davidlim4318/Baseball-Machine/README.md

# Baseball-Machine
MAE 156 Capstone Project Code Files
