davidlim4318/Baseball-Machine/KiCad/oc_v1/oc_v1.kicad_pcb

## KiCad design KiCad/oc_v1/oc_v1.kicad_pcb (2024-03-15)

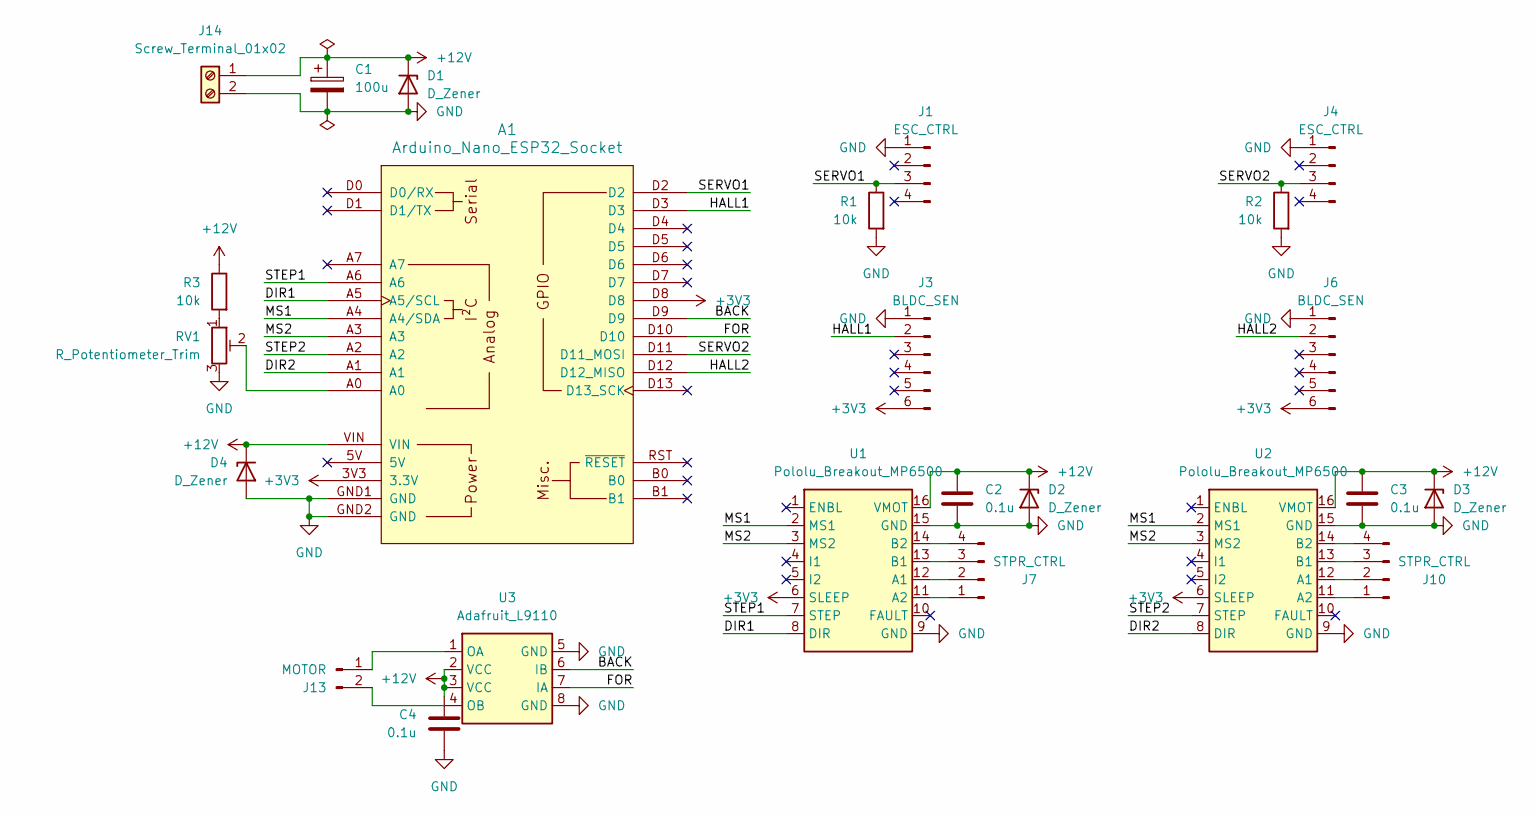
[picture p1: schematic oc_v1.kicad_sch, Onboard Controller V1]

Parts:
A1: Arduino_Nano_ESP32_Socket
C1: 100u; CP_Radial_D5.0mm_P2.50mm
C2, C3, C4: 0.1u; C_0603_1608Metric_Pad1.08x0.95mm_HandSolder
D1, D2, D3, D4: D_Zener; D_TUMD2
J1, J4: ESC_CTRL; JST_XH_S4B-XH-A_1x04_P2.50mm_Horizontal
J3, J6: BLDC_SEN; JST_XH_S6B-XH-A_1x06_P2.50mm_Horizontal
J7, J10: STPR_CTRL; JST_XH_S4B-XH-A_1x04_P2.50mm_Horizontal
J13: MOTOR; JST_XH_S2B-XH-A_1x02_P2.50mm_Horizontal
J14: Screw_Terminal_01x02; On_Shore_Tech_Barrier_Strip_2Pos
R1, R2, R3: 10k; R_0805_2012Metric_Pad1.20x1.40mm_HandSolder
RV1: R_Potentiometer_Trim; Bourns_TC33X_Potentiometer
U1, U2: Pololu_Breakout_MP6500
U3: Adafruit_L9110; DIP-8_W7.62mm_Socket_LongPads

Connections:
+3V3: A1.3V3 (3.3V), A1.D8, J3.6, J6.6, U1.6 (SLEEP), U2.6 (SLEEP)
+12V: A1.VIN, C1.1, C2.1, C3.1, C4.1, D1.1 (K), D2.1 (K), D3.1 (K), D4.1 (K), J14.1, R3.1, U1.16 (VMOT), U2.16 (VMOT), U3.2 (VCC), U3.3 (VCC)
/BACK: A1.D9, U3.6 (IB)
/DIR1: A1.A5 (A5/SCL), U1.8 (DIR)
/DIR2: A1.A1, U2.8 (DIR)
/FOR: A1.D10, U3.7 (IA)
/HALL1: A1.D3, J3.2
/HALL2: A1.D12 (D12_MISO), J6.2
/MS1: A1.A4 (A4/SDA), U1.2 (MS1), U2.2 (MS1)
/MS2: A1.A3, U1.3 (MS2), U2.3 (MS2)
/SERVO1: A1.D2, J1.3, R1.1
/SERVO2: A1.D11 (D11_MOSI), J4.3, R2.1
/STEP1: A1.A6, U1.7 (STEP)
/STEP2: A1.A2, U2.7 (STEP)
GND: A1.GND1 (GND), A1.GND2 (GND), C1.2, C2.2, C3.2, C4.2, D1.2 (A), D2.2 (A), D3.2 (A), D4.2 (A), J1.1, J3.1, J4.1, J6.1, J14.2, R1.2, R2.2, RV1.3, U1.9 (GND), U1.15 (GND), U2.9 (GND), U2.15 (GND), U3.5 (GND), U3.8 (GND)
unnamed: A1.A0, RV1.2
unnamed: J7.1, U1.11 (A2)
unnamed: J7.2, U1.12 (A1)
unnamed: J7.3, U1.13 (B1)
unnamed: J7.4, U1.14 (B2)
unnamed: J10.1, U2.11 (A2)
unnamed: J10.2, U2.12 (A1)
unnamed: J10.3, U2.13 (B1)
unnamed: J10.4, U2.14 (B2)
unnamed: J13.1, U3.1 (OA)
unnamed: J13.2, U3.4 (OB)
unnamed: R3.2, RV1.1

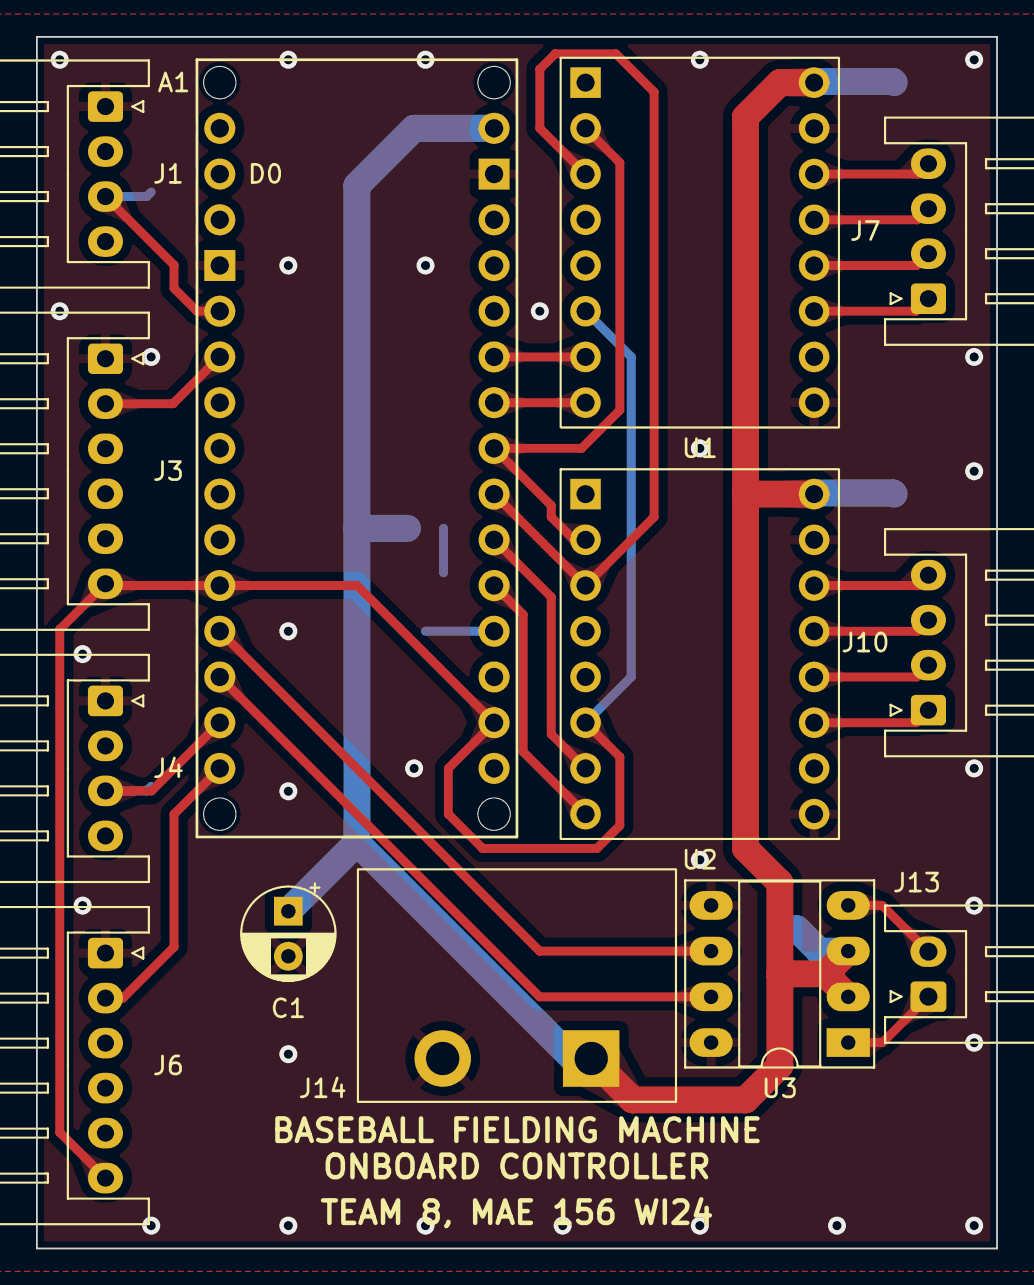
[picture p2: board oc_v1.kicad_pcb from above]

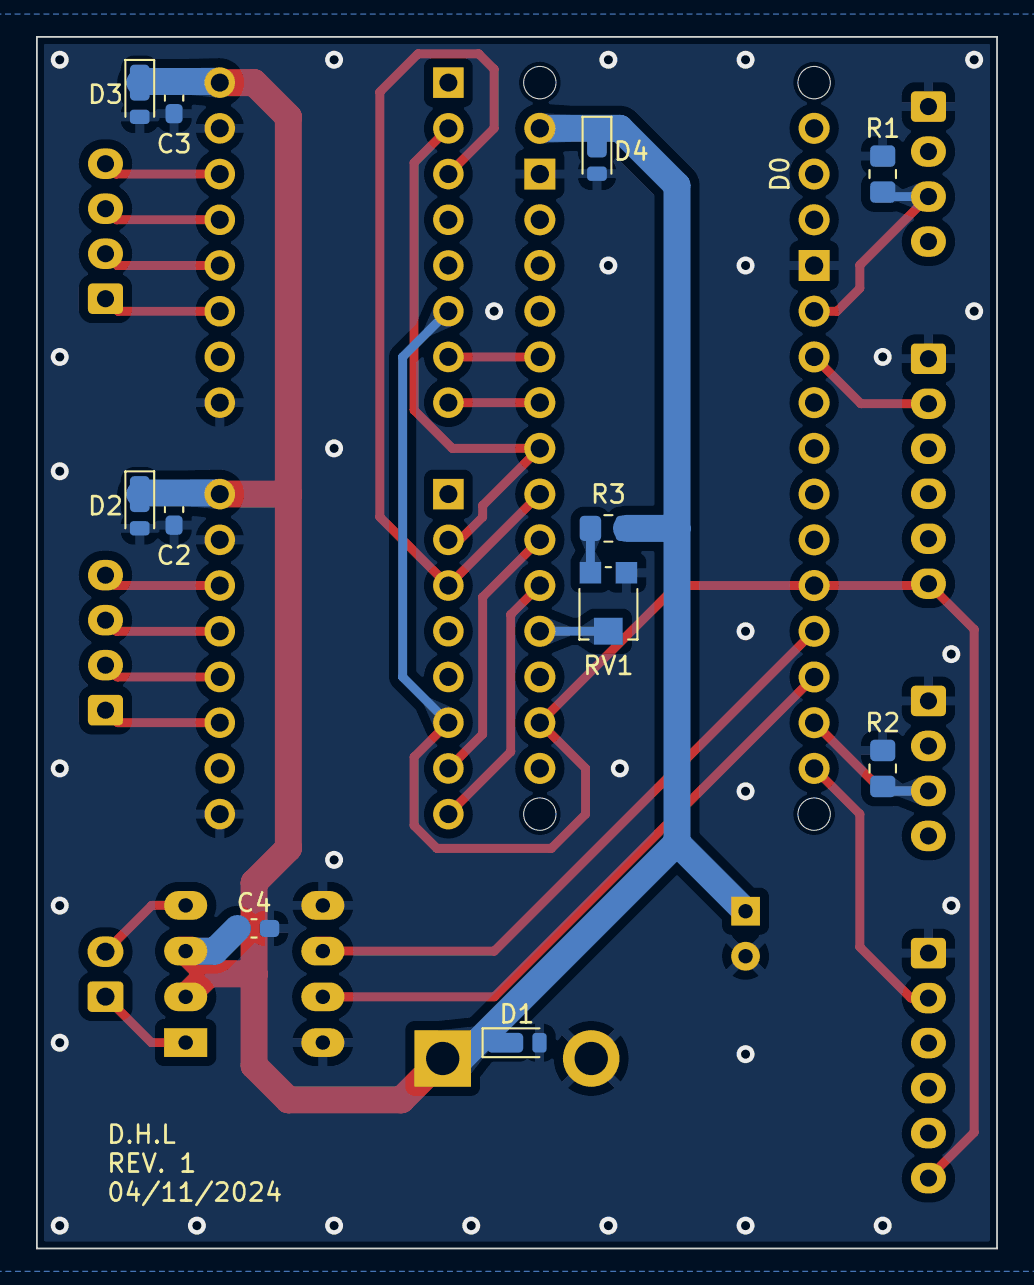
[picture p3: board oc_v1.kicad_pcb from below]

Board: 2 copper layers, 53.3 x 67.3 mm, 24 parts (11 on the bottom side), 27 nets.
