davidlim4318/Baseball-Machine/KiCad/rc_v1/rc_v1.kicad_pcb

## KiCad design KiCad/rc_v1/rc_v1.kicad_pcb (2024-01-12)

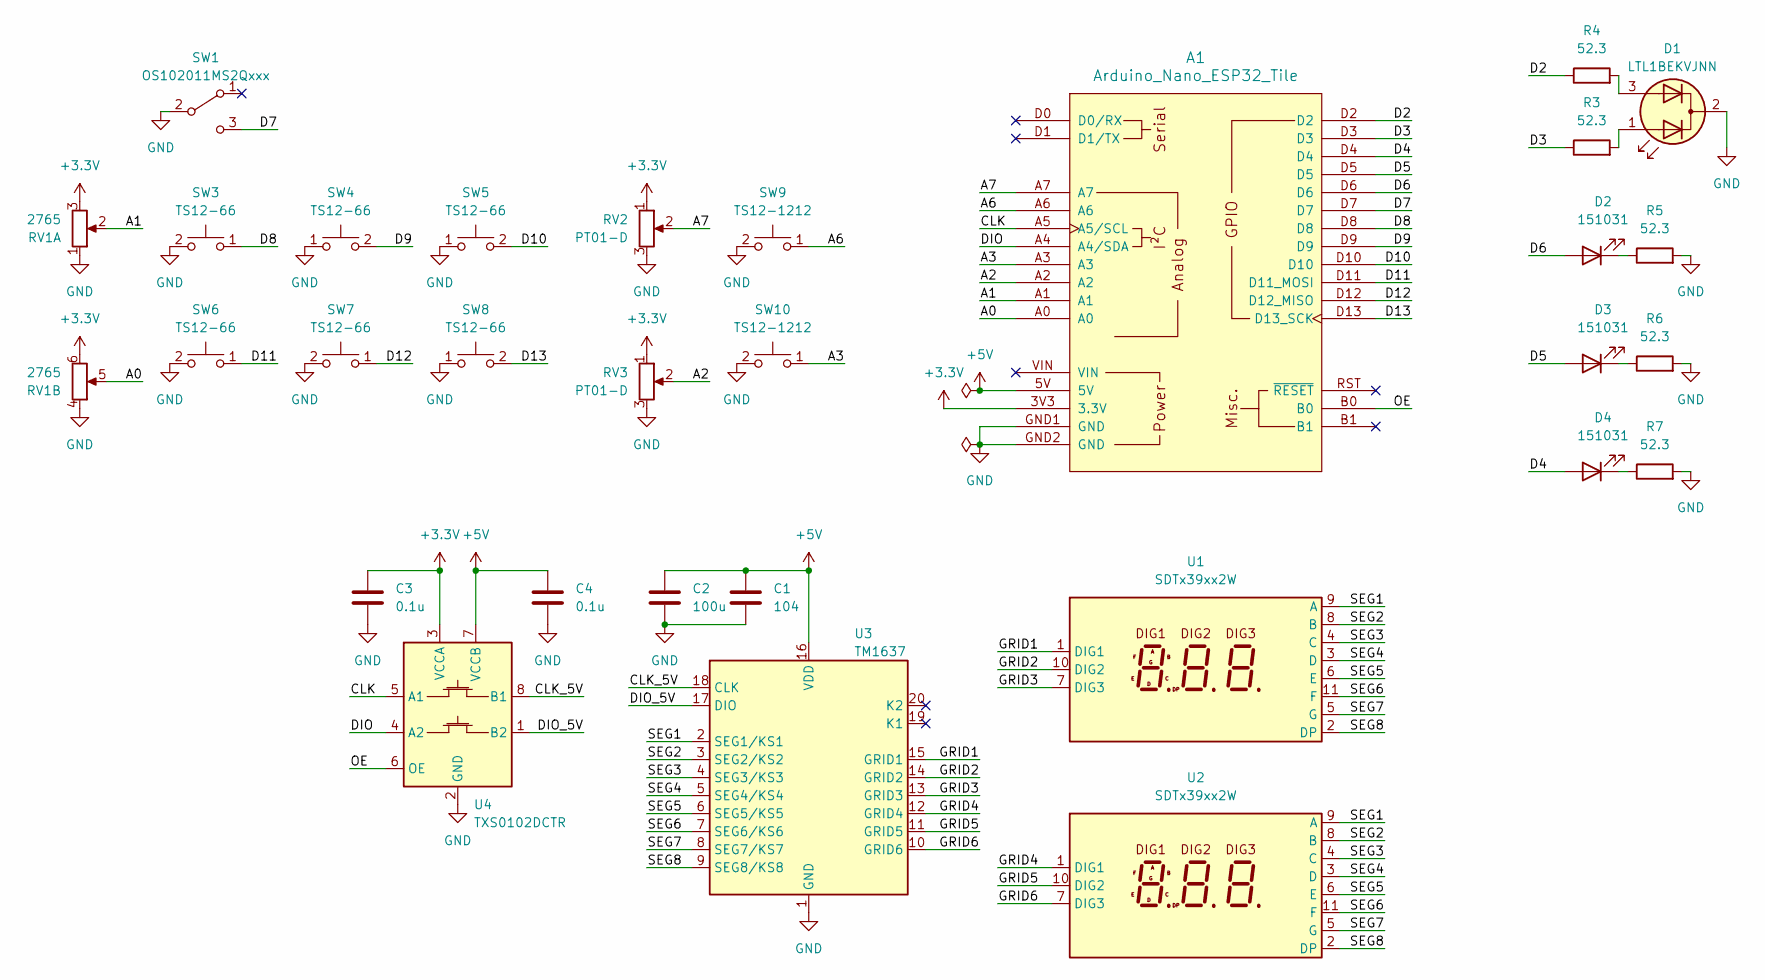
[picture p4: schematic rc_v1.kicad_sch, Remote Controller V1]

Parts:
A1: Arduino_Nano_ESP32_Tile
C1: 104; C_0603_1608Metric_Pad1.08x0.95mm_HandSolder
C2: 100u; C_0603_1608Metric_Pad1.08x0.95mm_HandSolder
C3, C4: 0.1u; C_0603_1608Metric_Pad1.08x0.95mm_HandSolder
D1: LTL1BEKVJNN; LED_D3.0mm-3
D2, D3, D4: 151031; LED_D3.0mm
R3, R4, R5, R6, R7: 52.3; R_0805_2012Metric_Pad1.20x1.40mm_HandSolder
RV1: 2765; Joystick_Analog_XY_Adafruit_2765
RV2, RV3: PT01-D; Potentiometer_CUI_PT01-Dxxxx-xxxx
SW1: OS102011MS2Qxxx; SW_Slide_SPDT_CK_OS102011MS2Qxxx
SW3, SW4, SW5, SW6, SW7, SW8: TS12-66; SW_PUSH_CUI_TS02-66-xxx-BK-xxx-xxx-D
SW9, SW10: TS12-1212; SW_PUSH-CUI-TS12-1212-xxx-BK-xxx-SCR-D
U1, U2: SDTx39xx2W; ChromeLED_SDTx39xx2W
U3: TM1637; SOP-20_7.5x12.8mm_P1.27mm
U4: TXS0102DCTR; SSOP-8_2.95x2.8mm_P0.65mm

Connections:
+3.3V: A1.3V3 (3.3V), C3.1, RV1.3, RV1.6, RV2.1, RV3.1, U4.3 (VCCA)
+5V: A1.5V, C1.1, C2.1, C4.1, U3.16 (VDD), U4.7 (VCCB)
/A0: A1.A0, RV1.5
/A1: A1.A1, RV1.2
/A2: A1.A2, RV3.2
/A3: A1.A3, SW10.1
/A6: A1.A6, SW9.1
/A7: A1.A7, RV2.2
/CLK: A1.A5 (A5/SCL), U4.5 (A1)
/CLK_5V: U3.18 (CLK), U4.8 (B1)
/D2: A1.D2, R4.1
/D3: A1.D3, R3.1
/D4: A1.D4, D4.2 (A)
/D5: A1.D5, D3.2 (A)
/D6: A1.D6, D2.2 (A)
/D7: A1.D7, SW1.3 (C)
/D8: A1.D8, SW3.1
/D9: A1.D9, SW4.2
/D10: A1.D10, SW5.2
/D11: A1.D11 (D11_MOSI), SW6.1
/D12: A1.D12 (D12_MISO), SW7.1
/D13: A1.D13 (D13_SCK), SW8.2
/DIO: A1.A4 (A4/SDA), U4.4 (A2)
/DIO_5V: U3.17 (DIO), U4.1 (B2)
/GRID1: U1.1 (DIG1), U3.15 (GRID1)
/GRID2: U1.10 (DIG2), U3.14 (GRID2)
/GRID3: U1.7 (DIG3), U3.13 (GRID3)
/GRID4: U2.1 (DIG1), U3.12 (GRID4)
/GRID5: U2.10 (DIG2), U3.11 (GRID5)
/GRID6: U2.7 (DIG3), U3.10 (GRID6)
/OE: A1.B0, U4.6 (OE)
/SEG1: U1.9 (A), U2.9 (A), U3.2 (SEG1/KS1)
/SEG2: U1.8 (B), U2.8 (B), U3.3 (SEG2/KS2)
/SEG3: U1.4 (C), U2.4 (C), U3.4 (SEG3/KS3)
/SEG4: U1.3 (D), U2.3 (D), U3.5 (SEG4/KS4)
/SEG5: U1.6 (E), U2.6 (E), U3.6 (SEG5/KS5)
/SEG6: U1.11 (F), U2.11 (F), U3.7 (SEG6/KS6)
/SEG7: U1.5 (G), U2.5 (G), U3.8 (SEG7/KS7)
/SEG8: U1.2 (DP), U2.2 (DP), U3.9 (SEG8/KS8)
GND: A1.GND1 (GND), A1.GND2 (GND), C1.2, C2.2, C3.2, C4.2, D1.2 (K), R5.2, R6.2, R7.2, RV1.1, RV1.4, RV2.3, RV3.3, SW1.2 (B), SW3.2, SW4.1, SW5.1, SW6.2, SW7.2, SW8.1, SW9.2, SW10.2, U3.1 (GND), U4.2 (GND)
unnamed: D1.1 (A1), R3.2
unnamed: D1.3 (A2), R4.2
unnamed: D2.1 (K), R5.1
unnamed: D3.1 (K), R6.1
unnamed: D4.1 (K), R7.1

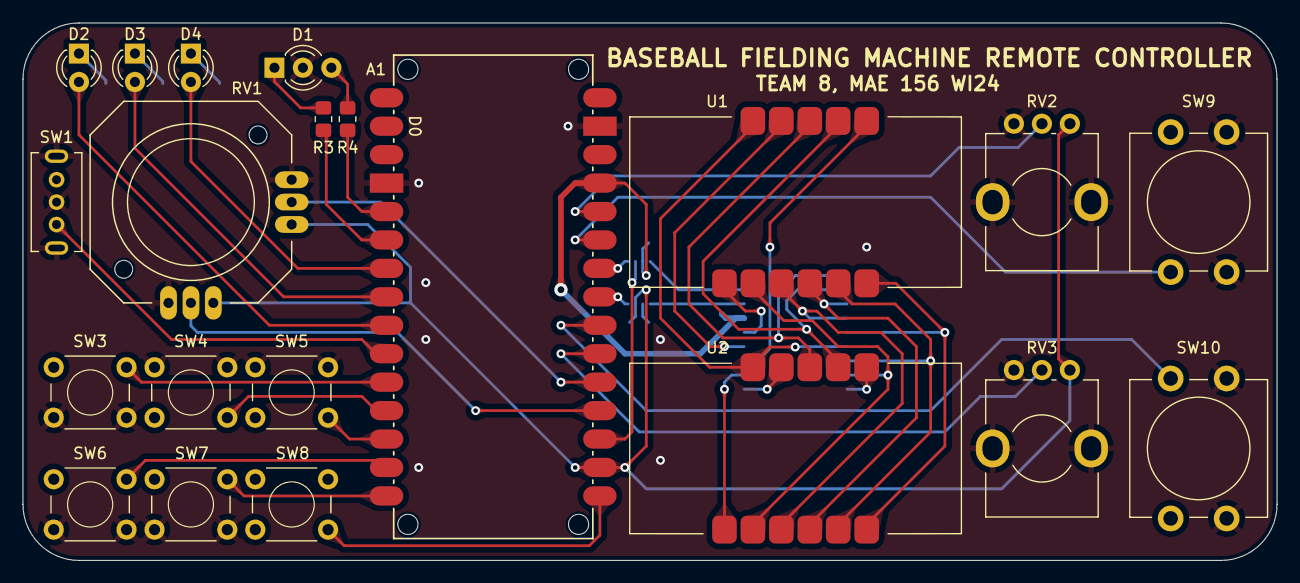
[picture p5: board rc_v1.kicad_pcb from above]

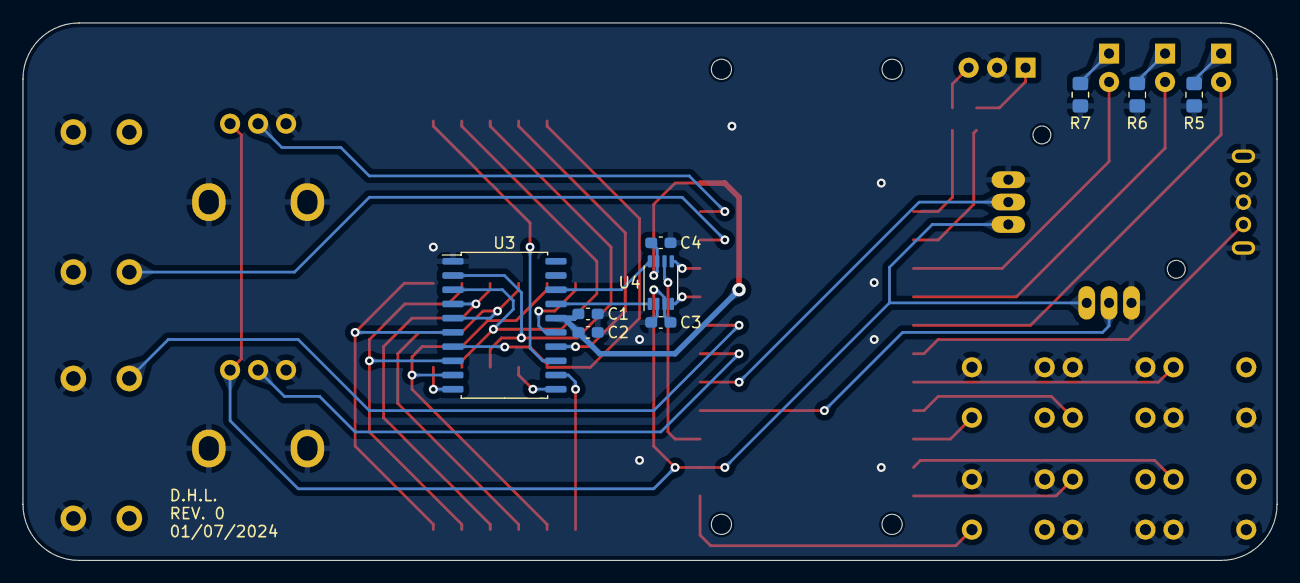
[picture p6: board rc_v1.kicad_pcb from below]

Board: 2 copper layers, 112.0 x 48.0 mm, 30 parts (9 on the bottom side), 45 nets.
