davidlim4318/Baseball-Machine/Arduino/OnboardController/OnboardController.ino

// Remote Controller Address: 48:07:C2:DD:4B:84
// Onboard Controller Address: EC:DA:3B:60:D1:98

#include <Arduino.h>
#include <esp_now.h>
#include <WiFi.h>
#include <ESP32Servo.h>
#include <AccelStepper.h>

//====================
// Pins

const int
  escPin[2] = { 11, 2 },
  hallSensorPin[2] = { 12, 3 },
  stepPin[2] = {A6, A2},
  directionPin[2] = {A5, A1},
  feedPin[2] = {10, 9},
  batteryPin = A0
;

//====================
// General variables/objects

float wheelRadius = 4.875;  // 2.5
float motorPoles = 14;   // 4

int gearboxX = 40;
int gearboxY = 100;

int speedMaxX = 3;
int speedMaxY = 3;

float stepSpeedMaxX = speedMaxX * gearboxX * 200 / 60.0;
float stepSpeedMaxY = speedMaxY * gearboxY * 200 / 60.0;

int accelerationTime = 1;

int period = 10;
int currentTime = 0;

int speedSetpointUpper;
int speedSetpointLower;

int moveCommandX;
int moveCommandY;
bool moveAutoX;
bool moveAutoY;

int feed;
bool feedSequence;

int speedUpper;
int speedLower;

int positionX;
int positionY;

int batterySOC;

int receiveTime = 0;
int dataSize;

bool connectionTimeout = false;

Servo escUpper;
Servo escLower;

AccelStepper stepperX(1, stepPin[0], directionPin[0]);
AccelStepper stepperY(1, stepPin[1], directionPin[1]);

//====================
// ESP-NOW definitions to send message

uint8_t broadcastAddress[] = { 0x48, 0x07, 0xC2, 0xDD, 0x4B, 0x84 };

typedef struct struct_message_onboard {
  int value1;
  int value2;
  int value3;
  int value4;
  int value5;
} struct_message_onboard;

struct_message_onboard messageToSend;

esp_now_peer_info_t peerInfo;

esp_now_send_status_t currentStatus;

void OnDataSent(const uint8_t *mac_addr, esp_now_send_status_t status) {
  if (currentStatus != status) {
    currentStatus = status;
    Serial.print("Connection Status: ");
    Serial.println(status == ESP_NOW_SEND_SUCCESS ? "Success" : "Fail");
  }
}

//====================
// ESP-NOW definitions to receive message

uint8_t MACAddress[] = { 0xEC, 0xDA, 0x3B, 0x60, 0xD1, 0x98 };

typedef struct struct_message_remote {
  int value1;
  int value2;
  int value3;
  int value4;
  bool value5;
  bool value6;
  int value7;
} struct_message_remote;

struct_message_remote messageToReceive;

void OnDataRecv(const uint8_t * mac, const uint8_t *incomingData, int len) {
  memcpy(&messageToReceive, incomingData, sizeof(messageToReceive));

  receiveTime = currentTime;
  dataSize = len;
  speedSetpointUpper = messageToReceive.value1;
  speedSetpointLower = messageToReceive.value2;
  moveCommandX = messageToReceive.value3;
  moveCommandY = messageToReceive.value4;
  moveAutoX = messageToReceive.value5;
  moveAutoY = messageToReceive.value6;
  feed = messageToReceive.value7;
}

//====================
// Setup

void setup() {

  //====================
  // General setup

  Serial.begin(9600);

  analogReadResolution(12);
  analogWriteResolution(12);

  //====================
  // ESC Setup

  escUpper.attach(escPin[0]);
  escLower.attach(escPin[1]);

  //====================
  // Hall Sensor Setup

  pinMode(hallSensorPin[0], INPUT_PULLUP);
  pinMode(hallSensorPin[1], INPUT_PULLUP);
  attachInterrupt(digitalPinToInterrupt(hallSensorPin[0]), measureSpeedUpper, CHANGE);
  attachInterrupt(digitalPinToInterrupt(hallSensorPin[1]), measureSpeedLower, CHANGE);

  //====================
  // Stepper Setup

  pinMode(stepPin[0],OUTPUT);
  pinMode(stepPin[1],OUTPUT);
  pinMode(directionPin[0],OUTPUT);
  pinMode(directionPin[1],OUTPUT);

  stepperX.setAcceleration(stepSpeedMaxX / accelerationTime);
  stepperY.setAcceleration(stepSpeedMaxY / accelerationTime);

  //====================
  // Feeder Setup

  pinMode(feedPin[0],OUTPUT);
  pinMode(feedPin[1],OUTPUT);

  //====================
  // ESP-NOW setup

  WiFi.mode(WIFI_OFF);
  Serial.println(WiFi.macAddress());
  if (esp_base_mac_addr_set(MACAddress) == ESP_OK) {
    Serial.println("MAC address set successfully");
  }
  else {
    Serial.println("Failed to set MAC address");
  }
  Serial.println(WiFi.macAddress());

  WiFi.mode(WIFI_STA);

  if (esp_now_init() != ESP_OK) {
    Serial.println("Error initializing ESP-NOW");
    return;
  }
  
  esp_now_register_send_cb(OnDataSent);

  memcpy(peerInfo.peer_addr, broadcastAddress, 6);
  peerInfo.channel = 0;  
  peerInfo.encrypt = false;

  if (esp_now_add_peer(&peerInfo) != ESP_OK) {
    Serial.println("Failed to add peer");
    return;
  }

  esp_now_register_recv_cb(OnDataRecv);
}

//====================
// Main loop

void loop() {

  if ((millis() - currentTime) > period) {

    currentTime = millis();

    checkMeasureSpeedTimeout();

    positionX = stepperX.currentPosition();
    positionY = stepperY.currentPosition();

    measureBattery();

    sendMessage();
    checkConnectionTimeout();

    controlSpeed();

    controlFeed();

    printData();
  }

  moveX();
  moveY();

  delayMicroseconds(500);
}

//====================
// measureSpeedUpper/Lower functions

int maxCount = motorPoles*5;

int changeTime1 = 0;
int changeCounter1 = 0;

void measureSpeedUpper() {
  changeCounter1 = ++changeCounter1;
  if (changeCounter1 >= maxCount) {
    int delta1 = micros() - changeTime1;
    changeTime1 = micros();
    speedUpper = changeCounter1 * 1000000.0 * 60.0 / delta1 / motorPoles;
    changeCounter1 = 0;
  }
}

int changeTime2 = 0;
int changeCounter2 = 0;

void measureSpeedLower() {
  changeCounter2 = ++changeCounter2;
  if (changeCounter2 >= maxCount) {
    int delta2 = micros() - changeTime2;
    changeTime2 = micros();
    speedLower = changeCounter2 * 1000000.0 * 60.0 / delta2 / motorPoles;
    changeCounter2 = 0;
  }
}

//====================
// checkMeasureSpeedTimeout function

int measureSpeedTimeoutDelay = 1000000;

void checkMeasureSpeedTimeout() {
  if (micros() - changeTime1 >= measureSpeedTimeoutDelay) {
    changeTime1 = micros();
    speedUpper = 0;
    changeCounter1 = 0;
  }
  if (micros() - changeTime2 >= measureSpeedTimeoutDelay) {
    changeTime2 = micros();
    speedLower = 0;
    changeCounter2 = 0;
  }
}

//====================
// measureBattery function

float voltage;

void measureBattery() {
  voltage = 0.005 * ( 3.3 * analogRead(batteryPin) ) / 4095 / 0.22 + 0.995 * voltage;
  batterySOC = 133.3 * (voltage - 12.65);
}

//====================
// sendMessage function

void sendMessage() {
  messageToSend.value1 = speedUpper * 0.00595 * wheelRadius;
  messageToSend.value2 = speedLower * 0.00595 * wheelRadius;
  messageToSend.value3 = positionX;
  messageToSend.value4 = positionY;
  messageToSend.value5 = batterySOC;

  esp_err_t result = esp_now_send(broadcastAddress, (uint8_t *) &messageToSend, sizeof(messageToSend));
}

//====================
// checkConnectionTimeout function

int connectionTimeoutDelay = 10000;

void checkConnectionTimeout() {
  if (currentTime - receiveTime > connectionTimeoutDelay) {
    connectionTimeout = true;
    dataSize = 0;
    speedSetpointUpper = 0;
    speedSetpointLower = 0;
    moveCommandX = 0;
    moveCommandY = 0;
    moveAutoX = false;
    moveAutoY = false;
    feed = 0;
    feedSequence = false;
  }
  else {
    connectionTimeout = false;
  }
}

//====================
// controlSpeed function

float maxTorqueFactor = 0.5;

float throttleUpper;
float throttleLower;

void controlSpeed() {

  float throttleMaxUpper = maxTorqueFactor + speedUpper / 5676.0;
  throttleUpper = constrain(speedSetpointUpper / 5676.0, 0, throttleMaxUpper);
  float throttleMaxLower = maxTorqueFactor + speedLower / 5676.0;
  throttleLower = constrain(speedSetpointLower / 5676.0, 0, throttleMaxLower);
  
  escUpper.writeMicroseconds(throttleUpper * 1000 + 1000);
  escLower.writeMicroseconds(throttleLower * 1000 + 1000);
}

//====================
// moveX function

void moveX() {
  if (moveAutoX) {
    stepperX.setMaxSpeed(stepSpeedMaxX);
    stepperX.moveTo(moveCommandX);
    stepperX.run();
  }
  else {
    stepperX.setMaxSpeed(stepSpeedMaxX * moveCommandX * 2  / 4095.0);
    stepperX.moveTo(stepperX.currentPosition() + 1000000 * moveCommandX);
    stepperX.run();
  }
}

//====================
// moveY function

void moveY() {
  if (moveAutoY) {
    stepperY.setMaxSpeed(stepSpeedMaxY);
    stepperY.moveTo(moveCommandY);
    stepperY.run();
  }
  else {
    stepperY.setMaxSpeed(stepSpeedMaxY * moveCommandY * 2  / 4095.0);
    stepperY.moveTo(stepperY.currentPosition() + 1000000 * moveCommandY);
    stepperY.run();
  }
}

//====================
// controlFeed function

int feedSequenceStart;

int feedForwardDelay = 250;
int feedStopDelay = 125;
int feedBackwardDelay = feedForwardDelay/2;

void controlFeed() {
  if (feed == -1) {
    feedSequence = false;
    digitalWrite(feedPin[0], LOW);
    digitalWrite(feedPin[1], HIGH);
  }
  else if (feedSequence == true) {
    if ((currentTime - feedSequenceStart) < feedForwardDelay) {
      digitalWrite(feedPin[0], HIGH);
      digitalWrite(feedPin[1], LOW);
    }
    else if ((currentTime - feedSequenceStart) < (feedForwardDelay + feedStopDelay)) {
      digitalWrite(feedPin[0], LOW);
      digitalWrite(feedPin[1], LOW);
    }
    else if ((currentTime - feedSequenceStart) < (feedForwardDelay + feedStopDelay + feedBackwardDelay)) {
      digitalWrite(feedPin[0], LOW);
      digitalWrite(feedPin[1], HIGH);
    }
    else if ((currentTime - feedSequenceStart) < (feedForwardDelay + 2*feedStopDelay + feedBackwardDelay)) {
      digitalWrite(feedPin[0], LOW);
      digitalWrite(feedPin[1], LOW);
    }
    else {
      feedSequence = false;
    }
  }
  else if (feed == 1) {
    feedSequenceStart = currentTime;
    feedSequence = true;
  }
  else {
    feedSequence = false;
    digitalWrite(feedPin[0], LOW);
    digitalWrite(feedPin[1], LOW);
  }
}

//====================
// printData function

void printData() {
  Serial.print(dataSize);
  Serial.print(", ");
  Serial.print(speedSetpointUpper);
  Serial.print(", ");
  Serial.print(speedUpper);
  Serial.print(", ");
  Serial.print(speedSetpointLower);
  Serial.print(", ");
  Serial.print(speedLower);
  Serial.print(", ");
  Serial.print(throttleUpper);
  Serial.print(", ");
  Serial.print(throttleLower);
  Serial.print(", ");
  Serial.print(moveCommandX);
  Serial.print(", ");
  Serial.print(moveAutoX);
  Serial.print(", ");
  Serial.print(moveCommandY);
  Serial.print(", ");
  Serial.print(moveAutoY);
  Serial.print(", ");
  Serial.print(positionX);
  Serial.print(", ");
  Serial.print(positionY);
  Serial.print(", ");
  Serial.print(feed);
  Serial.println(" ");
}
