davidlim4318/Baseball-Machine/(commit log)

2023-12-22 Added Arduino test files
2024-01-04 Remote Controller PCB Milestone 1
    Created Remote Controller PCB project, routed LED tracks
    [rc_v1.kicad_pcb, rc_v1.kicad_sch]
2024-01-04 Remote Controller PCB Milestone 2
    Routed right side inputs
    [rc_v1.kicad_pcb, rc_v1.kicad_sch]
2024-01-05 Remote Controller PCB Milestone 3
    Tentatively completed all connections
    [rc_v1.kicad_pcb, rc_v1.kicad_sch]
2024-01-06 Backup
    Will replace buffer with level shifter
    [rc_v1.kicad_pcb]
2024-01-07 Remote Controller PCB Milestone 5
    Added level shifter IC, prototype board nearly completed
    [rc_v1.kicad_pcb, rc_v1.kicad_sch]
2024-01-08 Remote Controller PCB Milestone 6
    Added GPIO output to OE input pin
    [rc_v1.kicad_pcb, rc_v1.kicad_sch]
2024-01-12 Design v1 Finished
    [rc_v1-B_Cu.gbr, rc_v1-B_Mask.gbr, rc_v1-B_Paste.gbr, rc_v1-B_Silkscreen.gbr, rc_v1-Edge_Cuts.gbr, rc_v1-F_Cu.gbr, rc_v1-F_Mask.gbr, rc_v1-F_Paste.gbr]
2024-02-05 Added servo library for esp32, added motor control
2024-02-17 Throttle control adjustments, added calibration script
2024-02-21 Started on onboard controller
    [oc_v1.kicad_pcb, oc_v1.kicad_sch]
2024-02-22 Completed onboard controller PCB
    [oc_v1-B_Cu.gbl, oc_v1-B_Mask.gbs, oc_v1-B_Paste.gbp, oc_v1-B_Silkscreen.gbo, oc_v1-Edge_Cuts.gm1, oc_v1-F_Cu.gtl, oc_v1-F_Mask.gts, oc_v1-F_Paste.gtp]
2024-03-02 fixed problem with pcb
    [oc_v1.kicad_pcb, oc_v1.kicad_sch]
2024-03-09 added battery voltage checker
2024-03-11 revised onboard pcb
    [oc_v1-B_Cu.gbl, oc_v1-B_Mask.gbs, oc_v1-B_Paste.gbp, oc_v1-B_Silkscreen.gbo, oc_v1-Edge_Cuts.gm1, oc_v1-F_Cu.gtl, oc_v1-F_Mask.gts, oc_v1-F_Paste.gtp]
2024-03-11 new arduino
2024-03-11 stepper X moves
2024-03-14 stepper works
2024-03-14 stepper 2 looks like it works
2024-03-15 improved onboard controller
    [oc_v1.kicad_pcb]
2024-03-15 new arduino (again)
2024-03-16 filtering speed output
2024-03-17 switched wheel ports
2024-03-31 KiCad Backups
